blkbny/Solder-Station/SolderingStation-master 1.0 - Mathuis/SolderingStation-master/README.md

# SolderingStation
Schemetics and Code for a DIY weller soldering station
Find more infos at https://debugginglab.wordpress.com/2014/10/30/soldering-station/
