blkbny/Solder-Station/SolderingStation-master 1.0 - Mathuis/SolderingStation-master/eagle/BOM.html

Last update: |  | 02.07.15 01:56
EAGLE version: |  | EAGLE Version 6.1.0 Copyright (c) 1988-2012 CadSoft
Item No. | Part value | Description | ID(s) | Quantity
1 | 100n | C0603 | C1, C3, C4, C5, C6 | 5
2 | 10u 16V | C1206 | C2 | 1
3 | 10u 6V | C1206 | C7 | 1
4 | OPA336U | SO08 | IC1 | 1
5 | 78L05F | SOT89 | IC2 | 1
6 | POWER_JACKPTH | POWER_JACK_PTH | J1 | 1
7 | Display Header | 1X08_LOCK | JP1 | 1
8 |  | 1X02_LOCK_LONGPADS | JP2, JP3 | 2
9 | M01PTH | 1X01 | JP4 | 1
10 | 100R | R0603 | R1 | 1
11 | 56k | R0603 | R2 | 1
12 | 1k | R0603 | R3, R4, R5, R6, R7, R8, R9, R10, R15, R18 | 10
13 | 10k | R0603 | R11, R12, R14 | 3
14 | 1M | R0603 | R13, R16 | 2
15 | IRF7416 | SO8 | T1 | 1
16 | BSN138 | SOT23 | T2, T3 | 2
17 | ARDUINO_PRO_MINI | ARDUINO_PRO_MINI | U$1 | 1
18 | AUDIO_JACK_3,5MMCONRAD | AUDIO_JACK_3,5MM_CONRAD | U$2 | 1
19 | MW_LOGO | MW_11X5MM | U$3, U$5 | 2
20 | MW_LOGO_SOLDER | MW_11X5MM_SOLDER | U$4, U$9 | 2
21 | SOLDER_STATION19,5MM_BOT | SOLDER_STATION_19,5MM_BOT | U$6, U$7 | 2
22 | OSH_LOGOS | OSH_LOGO_S | U$8, U$10 | 2
Total |  |  |  | 44
