blkbny/Solder-Station/new version/SolderingStation-master v1.0 Mathius/list.xlsx

Ref | Value | Make | SN | Description | Optional | supplier | Cost of 1 | cost of 10 | cost of 50 | Amount |  | Total
C1, C3, C4, C5, C6 | 100n | Kemet | C1206C104K5RAC7867 | CAP CER 0.1UF 50V X7R 1206 |  | digikey | 0.1 | 0.073 | 0.0398 | 5 |  | 0.5
C2 | 10u 16V | Wurth Electronics Inc | 885012108017 | CAP CER 10UF 16V X5R 1206 |  | digikey | 0.43 | - | 0.3434 | 1 |  | 0.43
C7 | 10u 6V | Wurth Electronics Inc | 885012108002 | CAP CER 10UF 6.3V X5R 1206 |  | digikey | 0.43 | - | 0.3434 | 1 |  | 0.43
IC1 | OPA336U | Texas Instruments | OPA336UA | IC OPAMP GP 100KHZ RRO 8SOIC |  | digikey | 1.99 | 1.789 | - | 1 |  | 1.99
IC2 | 78L05F | STMicroelectronics | L78L05ABUTR | IC REG LDO 5V 0.1A SOT89-3 |  | digikey | 0.43 | 0.348 | - | 1 |  | 0.43
J1 | POWER_JACKPTH |  |  |  |  |  |  |  |  | 1 |  | 0
JP1 | Display Header 1X08_LOCK |  |  |  |  |  |  |  |  | 1 |  | 0
JP2, JP3 | Display Header 1X02_LOCK_LONGPADS |  |  |  |  |  |  |  |  | 2 |  | 0
JP4 | M01PTH 1X01 |  |  |  |  |  |  |  |  | 1 |  | 0
R1 | 100R | Bourns Inc | CR0603-JW-101ELF | RES SMD 100 OHM 5% 1/10W 0603 |  | digikey | 0.1 | 0.029 | 0.0158 | 1 |  | 0.1
R2 | 56k | Bourns Inc | CR0603-FX-5602ELF | RES SMD 56K OHM 1% 1/10W 0603 |  | digikey | 0.1 | 0.046 | 0.0254 | 1 |  | 0.1
R3, R4, R5, R6, R7, R8, R9, R10, R15, R18 | 1k | Bourns Inc | CR0603-JW-102ELF | RES SMD 1K OHM 5% 1/10W 0603 |  | digikey | 0.1 | 0.029 | 0.0158 | 10 |  | 0.29
R11, R12, R14 | 10k | Bourns Inc | CR0603-JW-103ELF | RES SMD 10K OHM 5% 1/10W 0603 |  | digikey | 0.1 | 0.029 | 0.0158 | 3 |  | 0.3
R13, R16 | 1M | Bourns Inc. | CR0603-JW-105ELF | RES SMD 1M OHM 5% 1/10W 0603 |  | digikey | 0.1 | 0.029 | 0.0158 | 2 |  | 0.2
T1 | IRF7416 | Infineon Technologies Americas Corp. | IRF7416PBF | MOSFET P-CH 30V 10A 8-SOIC |  | digikey | 1.33 | 0.821 | 0.6672 | 1 |  | 1.33
T2, T3 | bss138 | Fairchild Semiconductor | BSS138 | MOSFET N-CH 50V 220MA SOT-23 |  | digikey | 0.22 | 0.178 | - | 2 |  | 0.44
U1 | ARDUINO_PRO_MINI |  |  |  |  |  |  |  |  | 1 |  | 0
U2 | AUDIO_JACK_3,5MMCONRAD |  |  |  |  |  |  |  |  | 1 |  | 0
 |  |  |  |  |  |  |  |  |  |  | Total | 6.54
