blkbny/Solder-Station/SolderingStation-master 1.0 - Mathuis/SolderingStation-master/3D/tapon.SLDPRT

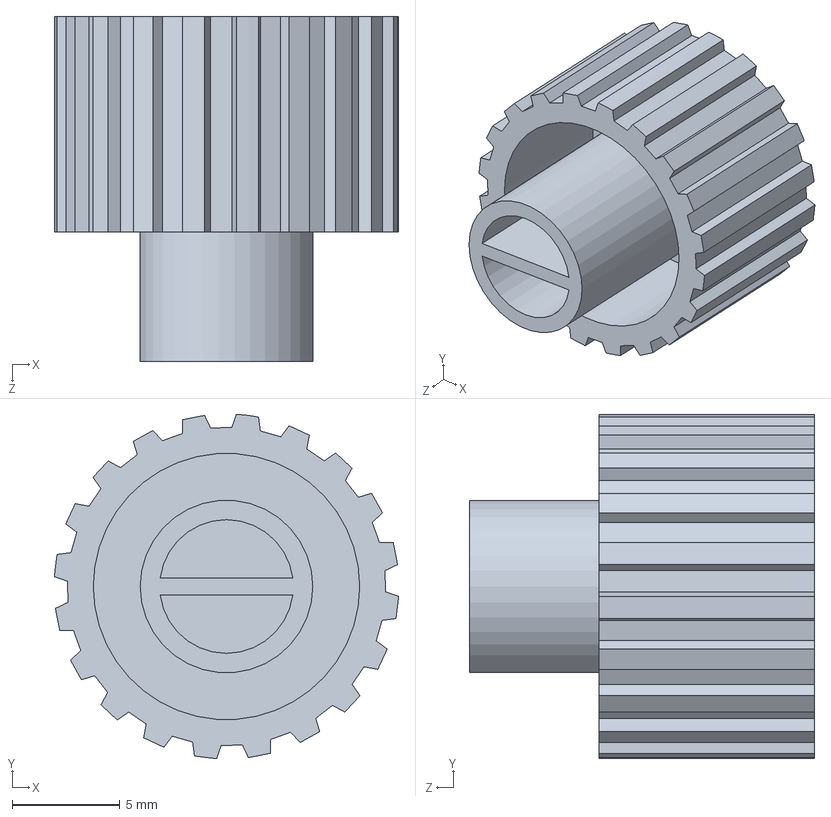
[picture p1: CAD file, 2015-12-15]
SolderingStation-master 1.0 - Mathuis/SolderingStation-master/3D/tapon.SLDPRT
16.0 x 16.0 x 16.0 mm
