blkbny/Solder-Station/SolderingStation-master 1.0 - Mathuis/SolderingStation-master/3D/lotstationtapa.SLDPRT

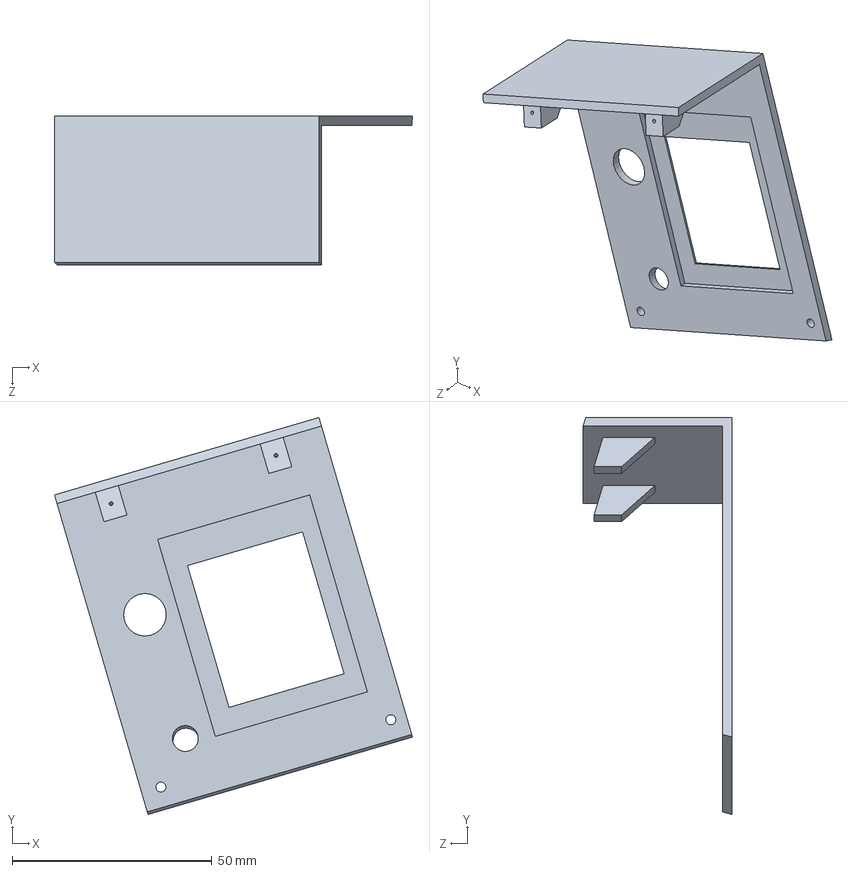
[picture p2: CAD file, 2015-12-15]
SolderingStation-master 1.0 - Mathuis/SolderingStation-master/3D/lotstationtapa.SLDPRT
89.6 x 99.4 x 37.3 mm
