blkbny/Solder-Station/SolderingStation-master 1.0 - Mathuis/SolderingStation-master/3D/lotstationv2.SLDPRT

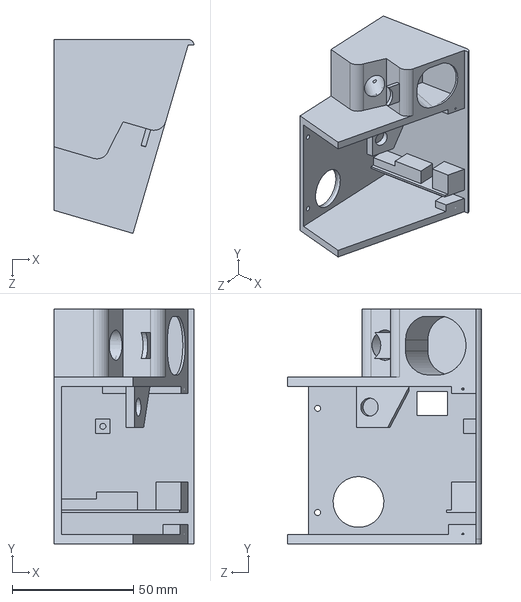
[picture p3: CAD file, 2015-12-15]
SolderingStation-master 1.0 - Mathuis/SolderingStation-master/3D/lotstationv2.SLDPRT
57.7 x 97.0 x 80.0 mm
