blkbny/Solder-Station/(list of files, cad)

Other CAD files:
universal solder iron/front/US_BootLoader.X/l.obj
universal solder iron/front/US_Firmware.X/l.obj
universal solder iron/sensor/US_sensor.X/dist/default/production/US_sensor.X.production.obj
universal solder iron/sensor/US_sensor.X/l.obj
SolderingStation-master 1.0 - Mathuis/SolderingStation-master/3D/lotstationtapa.STL
SolderingStation-master 1.0 - Mathuis/SolderingStation-master/3D/lotstationv2.STL
SolderingStation-master 1.0 - Mathuis/SolderingStation-master/3D/tapon.STL
