blkbny/Solder-Station/universal solder iron/gerber/unisolder52_full.txt

%FSTAX25Y25*%
%MOIN*%
%SFA1B1*%

%IPPOS*%
%ADD9500C,0.027990*%
%ADD9501C,0.031500*%
%ADD9502C,0.035430*%
%ADD9503C,0.039370*%
%ADD9504C,0.043310*%
%ADD9505C,0.047240*%
%ADD9506C,0.055120*%
%ADD9507C,0.066930*%
%ADD9508C,0.068900*%
%ADD9509C,0.090550*%
%ADD9510C,0.098430*%
%ADD9511C,0.125200*%
%ADD9512C,0.137800*%
%ADD9513C,0.145670*%
%LNunisolder52_full-1*%
%LPD*%
G54D9500*
X0136614Y0420866D03*
Y0427165D03*
Y0433465D03*
X0145276Y0430315D03*
Y0424016D03*
X0490256Y0275098D03*
X0490748Y0287894D03*
X0504528Y0288484D03*
X050689Y0299213D03*
X0495374Y0298524D03*
X0517913Y0302559D03*
X0525886Y0300886D03*
X0524311Y0290551D03*
X053435Y0289665D03*
X0535138Y0305315D03*
X054124Y0304429D03*
X0547244Y0305315D03*
X0558957Y0311516D03*
X0555118Y0289665D03*
X0544291Y0280413D03*
X0523228Y0275787D03*
X0576575Y028061D03*
X0576772Y0289862D03*
X0600394Y0291929D03*
X0607382Y0275787D03*
X0588583Y0308071D03*
X0453051Y029065D03*
X0452461Y0274902D03*
X0430315D03*
X04384Y0299095D03*
X0365256Y03D03*
X0364567Y0309449D03*
X0347091Y0312265D03*
X0343891Y0302165D03*
Y0296265D03*
X0345391Y0285465D03*
X0339491Y0286165D03*
X0332591Y0281465D03*
X0323591Y0291765D03*
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
