blkbny/Solder-Station/universal solder iron/resID.xlsx

Odd(red) resistor values for ID-Vout1- and for single resistor IDs (i.e. dual heater instruments) are reserved by the autor!
You can use them freely only on ID-Vout2.
ID(hex) | ID | R | Rmax | Rmin | ADCmin | ADCmax | ADCnom
1 | 1 | 100 | 101 | 99 | 89 | 93 | 87
2 | 2 | 110 | 111.1 | 108.9 | 97 | 102 | 95
3 | 3 | 120 | 121.2 | 118.8 | 105 | 110 | 103.5
4 | 4 | 130 | 131.3 | 128.7 | 113 | 118 | 111.5
5 | 5 | 150 | 151.5 | 148.5 | 128 | 135 | 123
6 | 6 | 180 | 181.8 | 178.2 | 150 | 157 | 142.5
7 | 7 | 200 | 202 | 198 | 164 | 172 | 160.5
8 | 8 | 220 | 222.2 | 217.8 | 177 | 186 | 174.5
9 | 9 | 240 | 242.4 | 237.6 | 190 | 199 | 188
A | 10 | 270 | 272.7 | 267.3 | 208 | 219 | 203.5
B | 11 | 300 | 303 | 297 | 226 | 238 | 222.5
C | 12 | 330 | 333.3 | 326.7 | 243 | 255 | 240.5
D | 13 | 390 | 393.9 | 386.1 | 273 | 289 | 264
E | 14 | 430 | 434.3 | 425.7 | 293 | 309 | 291
F | 15 | 470 | 474.7 | 465.3 | 310 | 329 | 309.5
10 | 16 | 560 | 565.6 | 554.4 | 347 | 370 | 338
11 | 17 | 680 | 686.8 | 673.2 | 389 | 417 | 379.5
12 | 18 | 820 | 828.2 | 811.8 | 432 | 463 | 424.5
13 | 19 | 1000 | 1010 | 990 | 476 | 514 | 469.5
14 | 20 | 1200 | 1212 | 1188 | 517 | 561 | 515.5
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
