blkbny/Solder-Station/universal solder iron/UniSolder52_back.pdf

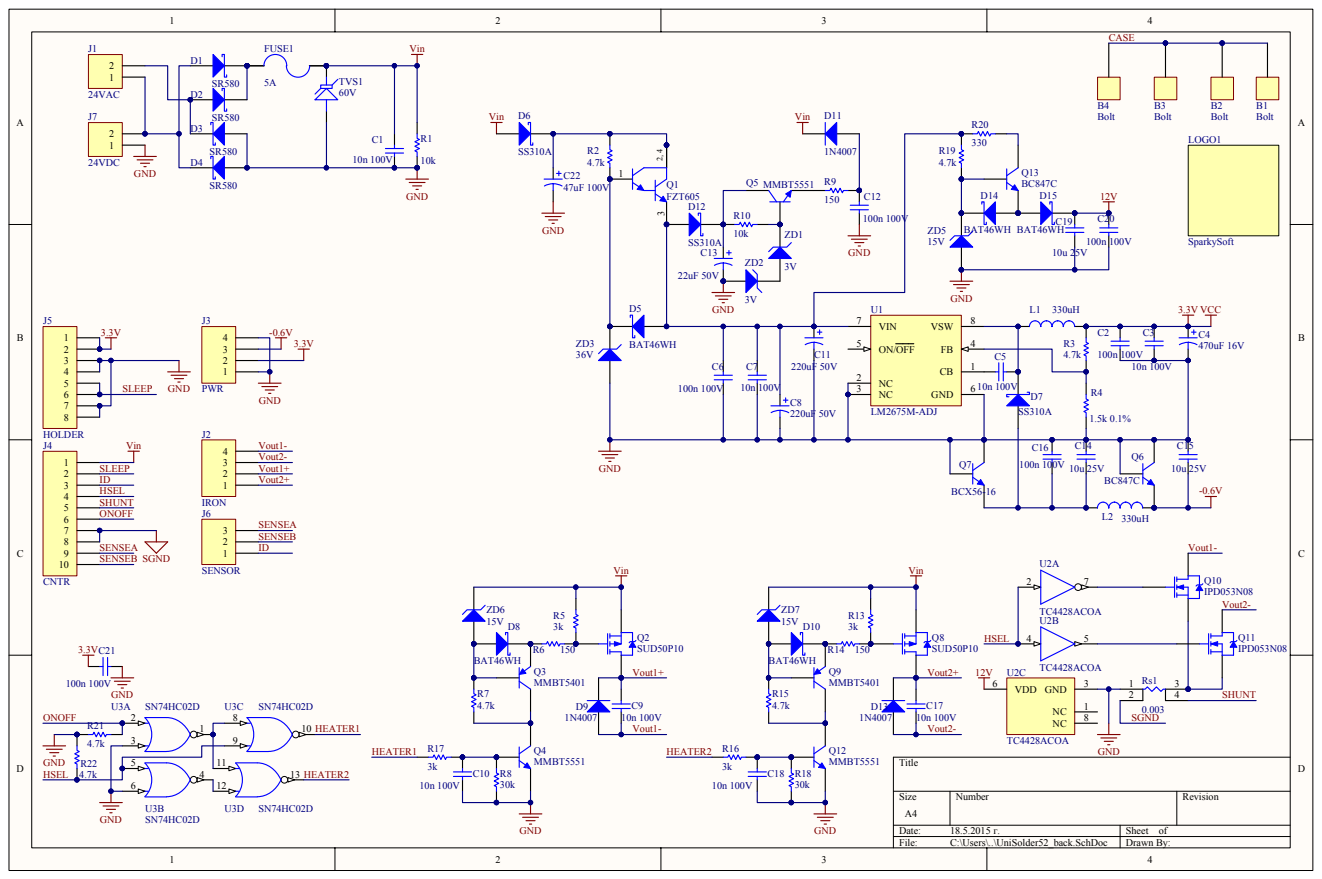
[picture p4: page 1]

Size A4 | Number | Revision

Date: 18.5.2015 г. | Sheet of
File: C:\Users\..\UniSolder52_back.SchDoc | Drawn By:
