blkbny/Solder-Station/universal solder iron/UniSolder52_OLED.pdf

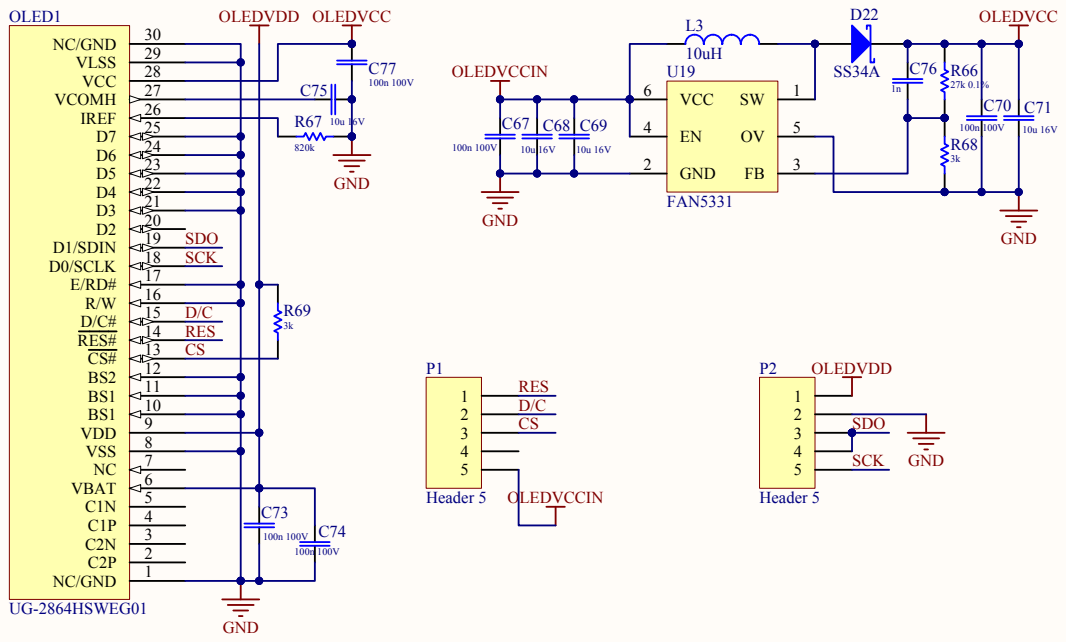
[picture p5: page 1]

Size A4 | Number | Revision

Date: 14.1.2015 г. | Sheet of
File: C:\Users\..\UniSolder52_OLED.SchDoc | Drawn By:
