blkbny/Solder-Station/universal solder iron/UniSolder_sensor.pdf

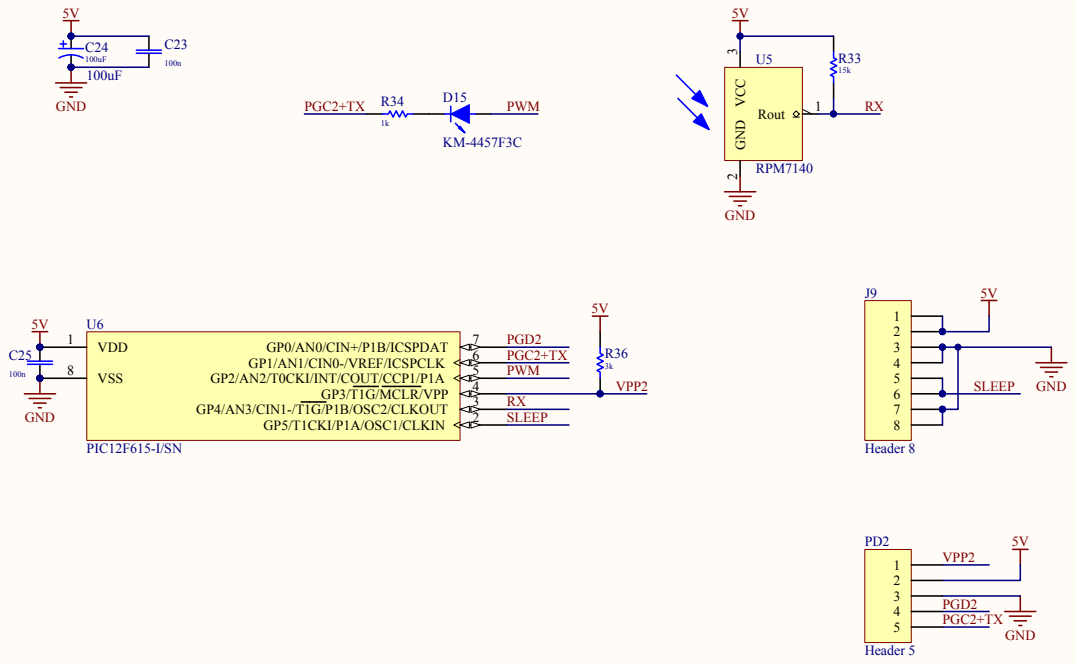
[picture p6: page 1]

Size A4 | Number | Revision

Date: 14.11.2014 г. | Sheet of
File: C:\Users\..\UniSolder_sensor.SchDoc | Drawn By:
