blkbny/Solder-Station/new version/eagle/solderiron2.0/SolderIron2.0.brd

## EAGLE design new version/eagle/solderiron2.0/SolderIron2.0.brd (2016-01-11)

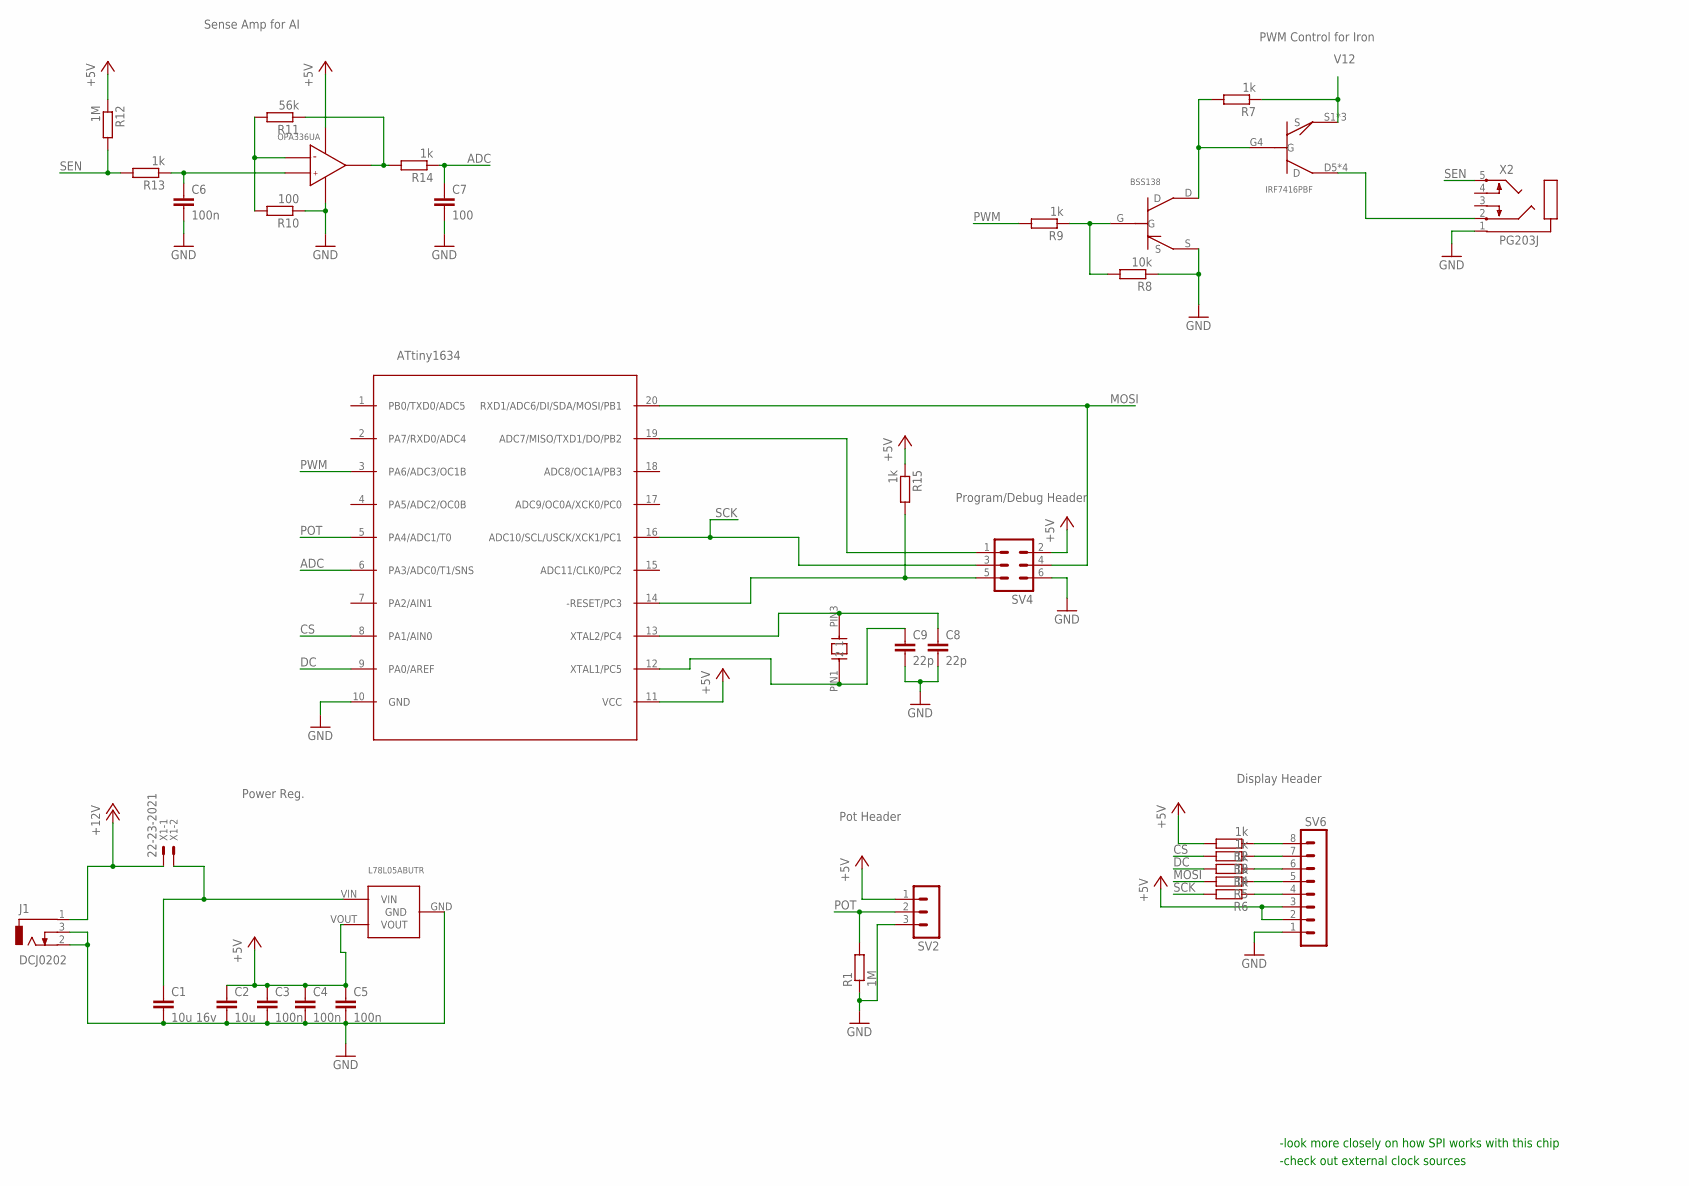
[picture p7: schematic SolderIron2.0.sch]

Parts:
C1: 10u 16v; C1206
C2: 10u; C1206
C3, C4, C5, C6: 100n; C1206
C7: 100; C1206
C8, C9: 22p; C1206
J1: DCJ0202; POWERJACK2.1MM
R1, R12: 1M; R0603
R2, R3, R4, R5, R6, R7, R9, R13, R14, R15: 1k; R0603
R8: 10k; R0603
R10: 100; R0603
R11: 56k; R0603
SV2: MA03-1
SV4: MA03-2
SV6: MA08-1
U$1: IRF7416PBF; 8-SOIC
U$2: L78L05ABUTR; SOT89-3
U$3: BSS138; SOT-23
U$4: OPA336UA; 8-SOIC
U$5: ATTINY1634; SOIC20
U$6: CX3225GB12000H0KPSC1; 4-SIZ
X1: 22-23-2021
X2: PG203J

Connections:
+5V: C2.1, C3.1, C4.1, C5.1, R2.2, R12.1, R15.1, SV2.1, SV4.2, SV6.2, SV6.3, U$2.VOUT, U$4.D7 (V+), U$5.11 (VCC)
+12V: J1.1, X1.1
ADC: C7.1, R14.1, U$5.6 (PA3/ADC0/T1/SNS)
CS: R3.2, U$5.8 (PA1/AIN0)
DC: R4.2, U$5.9 (PA0/AREF)
GND: C1.2, C2.2, C3.2, C4.2, C5.2, C6.2, C7.2, C8.2, C9.2, J1.2 (3), J1.3 (2), R1.1, R8.1, R10.1, SV2.3, SV4.6, SV6.1, U$2.GND, U$3.S, U$4.G4 (V-), U$5.10 (GND), X2.1
MOSI: R5.2, SV4.4, U$5.20 (RXD1/ADC6/DI/SDA/MOSI/PB1)
unnamed: C8.1, U$5.13 (XTAL2/PC4), U$6.PIN3 (2)
unnamed: R2.1, SV6.8
unnamed: R3.1, SV6.7
unnamed: R4.1, SV6.6
unnamed: R5.1, SV6.5
unnamed: R6.1, SV6.4
unnamed: U$1.D5 (D), U$1.D6 (D), U$1.D7 (D), U$1.D8 (D), X2.2
unnamed: R7.2, U$1.G4 (G), U$3.D
unnamed: R8.2, R9.1, U$3.G
unnamed: R10.2, R11.2, U$4.S2 (IN-)
unnamed: R11.1, R14.2, U$4.D6 (OUTPUT)
unnamed: C6.1, R13.1, U$4.S3 (IN+)
unnamed: C9.1, U$5.12 (XTAL1/PC5), U$6.PIN1 (1)
unnamed: SV4.1, U$5.19 (ADC7/MISO/TXD1/DO/PB2)
unnamed: R15.2, SV4.5, U$5.14 (-RESET/PC3)
POT: R1.2, SV2.2, U$5.5 (PA4/ADC1/T0)
PWM: R9.2, U$5.3 (PA6/ADC3/OC1B)
SCK: R6.2, SV4.3, U$5.16 (ADC10/SCL/USCK/XCK1/PC1)
SEN: R12.2, R13.2, X2.5
V12: C1.1, R7.1, U$1.S1 (S), U$1.S2 (S), U$1.S3 (S), U$2.VIN, X1.2

Notes on the sheet:
Power Reg.
Pot Header
Display Header
PWM Control for Iron
Sense Amp for AI
Program/Debug Header
-look more closely on how SPI works with this chip
-check out external clock sources

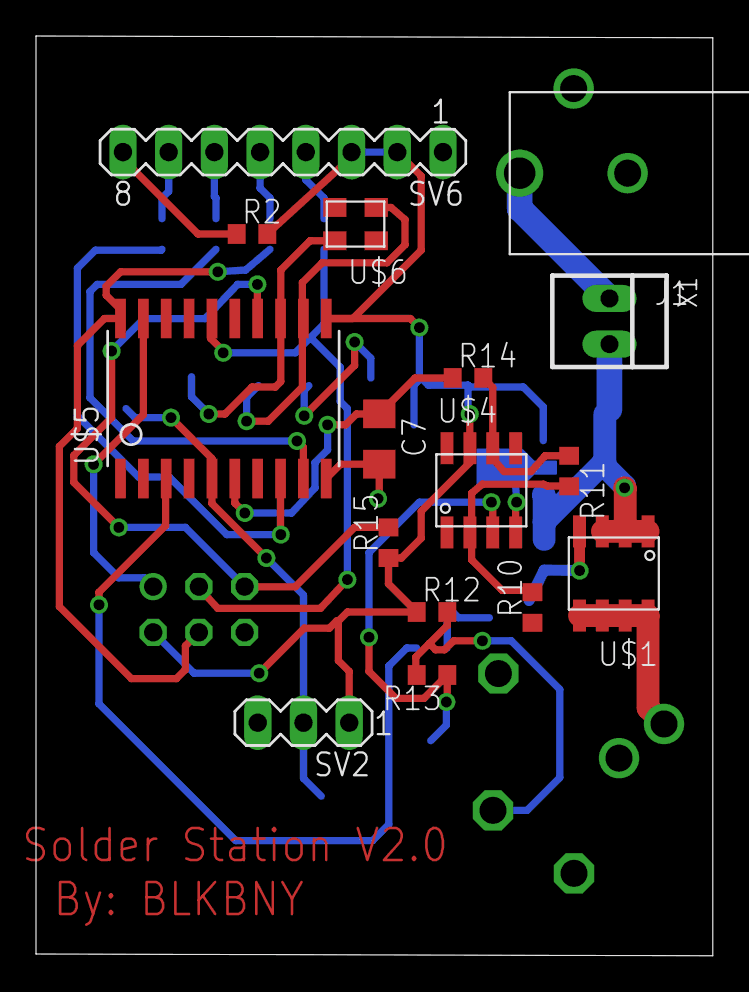
[picture p8: board SolderIron2.0.brd from above]

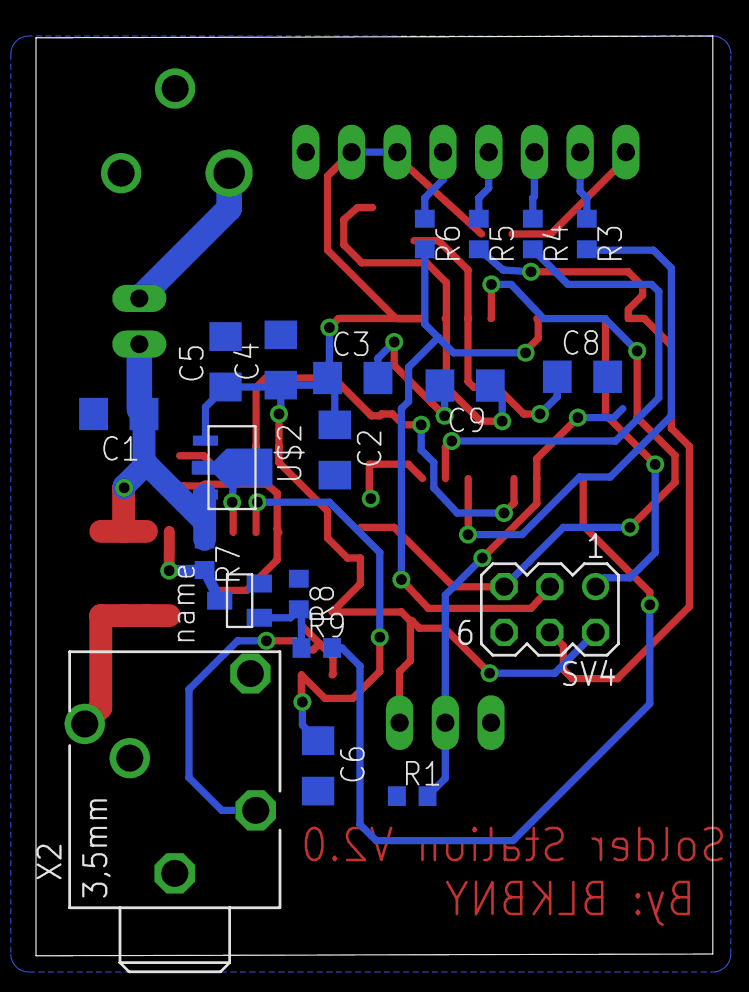
[picture p9: board SolderIron2.0.brd from below]

Board: 2 copper layers, 37.6 x 51.1 mm, 36 parts (20 on the bottom side), 27 nets.
