blkbny/Solder-Station/universal solder iron/front/US_Firmware.X/PIC32MX534F064H.c

#define _PIC32MX534F064H_C

#include <xc.h>
// DEVCFG3
// USERID = No Setting
#pragma config FSRSSEL = PRIORITY_7     // SRS Select (SRS Priority 7)
#pragma config FCANIO = OFF             // CAN I/O Pin Select (Alternate CAN I/O)
#pragma config FUSBIDIO = OFF           // USB USID Selection (Controlled by Port Function)
#pragma config FVBUSONIO = OFF          // USB VBUS OFF Selection (Not Controlled by USB Module)

// DEVCFG2
#pragma config FPLLIDIV = DIV_2         // PLL Input Divider (2x Divider)
#pragma config FPLLMUL = MUL_20         // PLL Multiplier (20x Multiplier)
#pragma config UPLLIDIV = DIV_2         // USB PLL Input Divider (2x Divider)
#pragma config UPLLEN = ON              // USB PLL Enable (Enabled)
#pragma config FPLLODIV = DIV_1         // System PLL Output Clock Divider (PLL Divide by 1)

// DEVCFG1
#pragma config FNOSC = PRIPLL           // Oscillator Selection Bits (Primary Osc w/PLL (XT+,HS+,EC+PLL))
#pragma config FSOSCEN = OFF            // Secondary Oscillator Enable (Disabled)
#pragma config IESO = OFF               // Internal/External Switch Over (Disabled)
#pragma config POSCMOD = XT             // Primary Oscillator Configuration (XT osc mode)
#pragma config OSCIOFNC = OFF           // CLKO Output Signal Active on the OSCO Pin (Disabled)
#pragma config FPBDIV = DIV_2           // Peripheral Clock Divisor (Pb_Clk is Sys_Clk/1)
#pragma config FCKSM = CSDCMD           // Clock Switching and Monitor Selection (Clock Switch Disable, FSCM Disabled)
#pragma config WDTPS = PS1048576        // Watchdog Timer Postscaler (1:1048576)
#pragma config FWDTEN = OFF             // Watchdog Timer Enable (WDT Disabled (SWDTEN Bit Controls))

// DEVCFG0
#pragma config DEBUG = OFF              // Background Debugger Enable (Debugger is disabled)
#pragma config ICESEL = ICS_PGx2        // ICE/ICD Comm Channel Select (ICE EMUC2/EMUD2 pins shared with PGC2/PGD2)
#pragma config PWP = OFF                // Program Flash Write Protect (Disable)
#pragma config BWP = OFF                // Boot Flash Write Protect bit (Protection Disabled)
#pragma config CP = OFF                 // Code Protect (Protection Disabled)

#include <GenericTypeDefs.h>
#include "PIC32MX534F064H.h"
#include <peripheral/system.h>
#include <peripheral/cmp.h>
#include <peripheral/timer.h>
#include <peripheral/ports.h>
#include <peripheral/adc10.h>
#include <peripheral/dma.h>
#include <peripheral/cvref.h>
#include <peripheral/cmp.h>
#include <peripheral/outcompare.h>
#include <peripheral/int.h>

#include "main.h"
#include "isr.h"

void mcuInit1(){
    INTDisableInterrupts();
    OpenCoreTimer(0xFFFFFFFF);
    SYSTEMConfigWaitStates(80000000);

    LATB=0b1000000000000000;
    LATC=0b0110000000000000;
    LATD=0b100001010000;
    LATE=0;
    LATF=0;
    LATG=0;
    TRISB=0b1100000000111111;
    TRISC=0b1001000000000000;
    TRISD=0;
    TRISE=0;
    TRISF=0;
    TRISG=0b1000111111;
    ODCB=0;
    ODCC=0;
    ODCD=0;
    ODCE=0;
    ODCF=0;
    ODCG=0;

    TRISBbits.TRISB7=0;

    HCH=0;
    ID_3S=0;
    ID_OUT=0;
    HEATER=0;
    CBANDA=1;
    CBANDB=1;
    CHSEL1=0;
    CHSEL2=1;
    CHPOL=0;

    SPEAKER=1;

    mcuADCStop();
}

void mcuInit2(){

    OpenTimer3(T3_ON | T3_IDLE_STOP | T3_GATE_OFF | T3_PS_1_256 | T3_SOURCE_INT, 40);
    OpenOC1(OC_ON | OC_IDLE_STOP | OC_TIMER_MODE16 | OC_TIMER3_SRC | OC_PWM_FAULT_PIN_DISABLE, 0x20, 0);

    DmaEnable(1);

    I2CEnable(I2C4, FALSE);
    mcuI2CReset();
    I2CSetFrequency(I2C4, PER_FREQ, 400000);
    I2CEnable(I2C4,TRUE);

    CVREFOpen(CVREF_ENABLE | CVREF_OUTPUT_DISABLE | CVREF_RANGE_HIGH | CVREF_SOURCE_VREF);
    COMPREF = 2; //(3*(0.25+2/32))*6 = 5.625V on Vin
    CMP2Open(CMP_STOP_IN_IDLE | CMP_ENABLE | CMP_OUTPUT_DISABLE | CMP_OUTPUT_INVERT | CMP_EVENT_HIGH_TO_LOW | CMP_POS_INPUT_CVREF | CMP2_NEG_INPUT_C2IN_NEG);
}

unsigned int mcuSqrt(register unsigned int n){
    register unsigned int r, x;
    r=0;
    for(x = 0x8000L; x; x >>= 1){
        r += x;
        if((UINT32)(r * r) > n)r -= x;
    }
    return r;
}

void DelayTicks(UINT32 a){
    UINT32 StartTime;
    StartTime=ReadCoreTimer();
    while((UINT32)(ReadCoreTimer()-StartTime)<a){};
}

void mcuJumpToBootLoader(){
    NVMDATA=0x6193471A;
    SoftReset();
}

void mcuSPIWait(){
    while(mcuSPIIsBusy());
}

void mcuI2CReset()
{
    SDALAT=0;
    SCLLAT=0;
    SCL=1;
    SDAOUT=1;
    _delay_us(100);
    while(SDA==0){
        SCL=0;
        _delay_us(100);
        SCL=1;
        _delay_us(100);
    }
    SDAOUT=0;
    _delay_us(100);
    SDAOUT=1;
    _delay_us(100);
}

void mcuDCTimerReset(){
    WriteTimer1(0);
    mT1ClearIntFlag();
}

void mcuInitISRTimer(){
    OpenTimer2(T2_OFF | T2_IDLE_STOP | T2_GATE_OFF | T2_PS_1_256 | T2_32BIT_MODE_OFF | T2_SOURCE_INT,0xFFFF);
    ConfigIntTimer2(T2_INT_ON | T2_INT_PRIOR_7 | T2_INT_SUB_PRIOR_3);
}

void mcuStartISRTimer(unsigned int per)
{
    WriteTimer2(0);
    WritePeriod2(per);
    T2CONbits.ON = 1;
}

void mcuStopISRTimer(){
    WriteTimer2(0);
    T2CONbits.ON = 0;
    mT2ClearIntFlag();
}

int ADCAuto = 0;

void mcuADCStop(){
    int i;
    if(ADCAuto && !VIBuffCnt) VIBuffCnt = DmaChnGetDstPnt(DMA_CHANNEL0);
    DmaChnAbortTxfer(DMA_CHANNEL0);
    DmaChnAbortTxfer(DMA_CHANNEL1);
    DmaChnDisable(DMA_CHANNEL0);
    DmaChnDisable(DMA_CHANNEL1);
    CloseADC10();
    i=ADC1BUF0;
    i=ADC1BUF1;
    i=ADC1BUF2;
    i=ADC1BUF3;
    i=ADC1BUF4;
    i=ADC1BUF5;
    i=ADC1BUF6;
    i=ADC1BUF7;
    i=ADC1BUF8;
    i=ADC1BUF9;
    i=ADC1BUFA;
    i=ADC1BUFB;
    i=ADC1BUFC;
    i=ADC1BUFD;
    i=ADC1BUFE;
    i=ADC1BUFF;
    mAD1ClearIntFlag();
    mAD1IntEnable(0);
    ADCAuto=0;
}

void mcuADCStartManual(){
    mcuADCStop();
    OpenADC10(\
            ADC_MODULE_ON | ADC_IDLE_STOP | ADC_FORMAT_INTG16 | ADC_CLK_AUTO | ADC_AUTO_SAMPLING_OFF | ADC_SAMP_OFF , \
            ADC_VREF_EXT_EXT | ADC_OFFSET_CAL_DISABLE | ADC_SCAN_OFF | ADC_SAMPLES_PER_INT_1 | ADC_BUF_16 | ADC_ALT_INPUT_OFF, \
            ADC_SAMPLE_TIME_13 | ADC_CONV_CLK_PB | ADC_CONV_CLK_5Tcy, \
            ENABLE_AN0_ANA | ENABLE_AN1_ANA | ENABLE_AN2_ANA | ENABLE_AN3_ANA | ENABLE_AN4_ANA | ENABLE_AN5_ANA | ENABLE_AN14_ANA, \
            SKIP_SCAN_ALL);
    AD1CON1bits.CLRASAM = 0;
    mAD1IntEnable(1);
    ADCAuto = 0;
}

void mcuADCStartAuto(){
    mcuADCStop();

    DmaChnDisable(DMA_CHANNEL0);
    DmaChnOpen(DMA_CHANNEL0,DMA_CHN_PRI0,DMA_OPEN_DEFAULT);
    DmaChnSetEventControl(DMA_CHANNEL0, DMA_EV_START_IRQ_EN | DMA_EV_START_IRQ(_ADC_IRQ));
    DmaChnSetTxfer(DMA_CHANNEL0,(void*)&ADC1BUF0,(void*)VBuff,2,sizeof(VBuff),2);
    DmaChnWriteEvEnableFlags(DMA_CHANNEL0,0);
    DmaChnEnable(DMA_CHANNEL0);

    DmaChnDisable(DMA_CHANNEL1);
    DmaChnOpen(DMA_CHANNEL1,DMA_CHN_PRI0,DMA_OPEN_DEFAULT);
    DmaChnSetEventControl(DMA_CHANNEL1, DMA_EV_START_IRQ_EN | DMA_EV_START_IRQ(_ADC_IRQ));
    DmaChnSetTxfer(DMA_CHANNEL1,(void*)&ADC1BUF1,(void*)IBuff,2,sizeof(IBuff),2);
    DmaChnWriteEvEnableFlags(DMA_CHANNEL1,0);
    DmaChnEnable(DMA_CHANNEL1);

    SetChanADC10(ADCH_VIN | (ADCH_VSHUNT<<8));
    OpenADC10(\
            ADC_MODULE_ON | ADC_IDLE_STOP | ADC_FORMAT_INTG16 | ADC_CLK_AUTO | ADC_AUTO_SAMPLING_ON | ADC_SAMP_ON , \
            ADC_VREF_EXT_EXT | ADC_OFFSET_CAL_DISABLE | ADC_SCAN_OFF | ADC_SAMPLES_PER_INT_2 | ADC_BUF_16 | ADC_ALT_INPUT_ON, \
            ADC_SAMPLE_TIME_31 | ADC_CONV_CLK_PB | ADC_CONV_CLK_63Tcy2, \
            ENABLE_AN0_ANA | ENABLE_AN1_ANA | ENABLE_AN2_ANA | ENABLE_AN3_ANA | ENABLE_AN4_ANA | ENABLE_AN5_ANA | ENABLE_AN14_ANA, \
            SKIP_SCAN_ALL);
    AD1CON1bits.CLRASAM = 0;
    ADCAuto = 1;
}

void mcuADCRead(int ADCCH, int num){
    SetChanADC10(ADCCH);
    AD1CON2bits.SMPI = num-1;
    AD1CON1bits.ASAM = 1;
    AD1CON1bits.CLRASAM = 1;
    AcquireADC10();
}

int mcuADCReadWait(int ADCCH, int num){
    int ADCInt,i;
    ADCInt = mAD1GetIntEnable();
    mAD1IntEnable(0);
    mAD1ClearIntFlag();
    mcuADCRead(ADCCH, num);
    while(!mAD1GetIntFlag());
    i=0;
    while(num--) i += ReadADC10(num);
    mAD1ClearIntFlag();
    mAD1IntEnable(ADCInt);
    return i;
}

static UINT32 H2LTime = 0;
void __ISR(_COMPARATOR_2_VECTOR, IPL7SRS) ComparatorISR(void)
{
    static int oh;
    static int oas;
    UINT32 ccon = CM2CON;
    mcuCompDisable();
    if(ccon & CMP_EVENT_HIGH_TO_LOW){
        mcuDCTimerReset();
        oh = HEATER;
        oas = (ADCStep & 1);
        //if(oh && oas)LATBbits.LATB7 = 1;
        H2LTime = ReadCoreTimer();
        ISRHigh(CompH2L);
    }
    else{
        CompLowTime = 0;
        if(H2LTime){
            CompLowTime = (ReadCoreTimer() - H2LTime) / 80;
            H2LTime = 0;
            //if(oh && oas)LATBbits.LATB7 = 0;
        }
        ISRHigh(CompL2H);
    }
}

void __ISR(_TIMER_1_VECTOR, IPL7SRS) Timer1ISR(void)
{
    mT1ClearIntFlag();
    H2LTime = 0;
    CompLowTime = 0;
    ISRHigh(DCTimer);
}

void __ISR(_TIMER_2_VECTOR, IPL7SRS) Timer2ISR(void)
{
    mT2ClearIntFlag();
    T2CONbits.ON = 0;
    ISRHigh(0);
}

void __ISR(_ADC_VECTOR,IPL7SRS) ADCISR(void)
{
    int n, i=0;
    for(n = AD1CON2bits.SMPI + 1; n--;) i += ReadADC10(n);
    mcuADCRES = i;
    mAD1ClearIntFlag();
    ISRHigh(0);
}

void __ISR(_I2C_4_VECTOR,IPL6SOFT) I2CISR(void)
{
    INTClearFlag(INT_I2C4B);
    INTClearFlag(INT_I2C4M);
    INTClearFlag(INT_I2C4S);
    INTClearFlag(INT_I2C4);
    I2CISRTasks();
}

void __ISR(_OUTPUT_COMPARE_2_VECTOR,IPL5SOFT) PIDISR(void){
    INTClearFlag(INT_OC2);
}

#undef _PIC32MX534F064H_C
