blkbny/Solder-Station/universal solder iron/front/US_Firmware.X/ExtFloat.h

/* 
 * File:   ExtFloat.h
 * Author: Sparky
 *
 * Created on ??????, 2015, ??? 17, 19:35
 */

#ifndef EXTFLOAT_H
#define	EXTFLOAT_H

#ifdef	__cplusplus
extern "C" {
#endif

typedef union{
    struct __PACKED
    {
        unsigned int m:23;
        unsigned int e:8;
        unsigned int s:1;
    };
    float f;
}SFLOAT;

typedef struct {
    UINT32 m;
    INT32 e;
}ExtFloat;

#define float2ExtFloat(ef, f) \
{ \
    ef.m = ( ((UINT32)((SFLOAT)f).m) | 0x800000UL) << 8; \
    ef.e = ((SFLOAT)f).e; \
}

#define ExtFloatDivByUInt(ef, ui) \
{ \
    if(ef.m /= ui){ \
        while (ef.m < 0x80000000UL){ \
            ef.m <<= 1; \
            ef.e--; \
        } \
    } \
    else { \
        ef.e = 0; \
    } \
}

#define ExtFloatMul(ef1, ef2) \
{ \
    if(ef1.m = ((UINT64)ef1.m * (UINT64)ef2.m) >> 32){ \
        ef1.e += ef2.e - 126; \
        while(ef1.m < 0x80000000UL){ \
            ef1.m <<= 1; \
            ef1.e--; \
        } \
    } \
    else { \
        ef1.e = 0; \
    } \
}

#define ExtFloatAdd(ef1, ef2) \
{\
    if(ef1.e >= ef2.e){ \
        if((ef1.e - ef2.e) < 31){ \
            if(ef1.m = (ef1.m >> 1) + (ef2.m >> (ef1.e - ef2.e + 1))){ \
                if(ef1.m >= 0x80000000UL){ \
                    ef1.e++; \
                } \
                else{ \
                    ef1.m <<= 1; \
                } \
            }\
            else{ \
                ef1.e = 0; \
            } \
        } \
    } \
    else { \
        if((ef2.e - ef1.e) < 31){ \
            if(ef1.m = (ef2.m >> 1) + (ef1.m >> (ef2.e - ef1.e + 1))){ \
                ef1.e = ef2.e; \
                if(ef1.m >= 0x80000000UL){ \
                    ef1.e++; \
                } \
                else{ \
                    ef1.m <<= 1; \
                } \
            }\
            else{ \
                ef1.e = 0; \
            } \
        } \
        else{ \
            ef1 = ef2; \
        } \
    } \
}
#ifdef	__cplusplus
}
#endif

#endif	/* EXTFLOAT_H */
