blkbny/Solder-Station/universal solder iron/front/US_Firmware.X/mcu.h

/* 
 * File:   mcu.h
 * Author: Sparky
 *
 * Created on ?????, 2013, ??? 31, 0:00
 */

#ifndef MCU_H
#define	MCU_H

#ifdef	__cplusplus
extern "C" {
#endif
    
#include <xc.h>

#ifdef __32MX534F064H__
#include "PIC32MX534F064H.h"
#endif




#ifdef	__cplusplus
}
#endif

#endif	/* MCU_H */
