blkbny/Solder-Station/universal solder iron/front/US_Firmware.X/menu.h

/* 
 * File:   menu.h
 * Author: Sparky
 *
 * Created on ???????, 2013, ??? 2, 23:27
 */

#ifndef MENU_H
#define	MENU_H

#ifdef	__cplusplus
extern "C" {
#endif

extern void MenuInit();
extern void MenuTasks();

#ifdef	__cplusplus
}
#endif

#endif	/* MENU_H */
