blkbny/Solder-Station/(commit log)

2015-12-15 adding open source base project for modification
    [list.xlsx, lotstationtapa.SLDPRT, lotstationtapa.STL, lotstationv2.SLDPRT, lotstationv2.STL, pin assign - ATtiny1634.xlsx, solderstation_v1_6.brd, solderstation_v1_6.sch]
2015-12-18 added another solder project for reference
    [US_sensor.X.production.obj, UniSolder52_BOM.xls, l.obj, lotstationtapa.SLDPRT, lotstationtapa.STL, lotstationv2.SLDPRT, lotstationv2.STL, resID.xlsx]
2015-12-21 added powersupply circuit
    [SolderIron2.0.sch, sloderiron2.0.brd]
2015-12-22 created eagle schematics
    [SolderIron2.0.sch, pin assign - ATtiny1634.xlsx, sloderiron2.0.brd]
2015-12-23 finished v2 schematic
    [SolderIron2.0.sch]
2015-12-23 first board setup
    [SolderIron2.0.brd, SolderIron2.0.sch]
2016-01-04 created new PCB layout
2016-01-05 finished PCB part layout
    [SolderIron2.0.sch]
2016-01-11 routed new board
    [SolderIron2.0.brd, SolderIron2.0.sch]
2016-01-11 added title to PCB
    [SolderIron2.0.brd]
2016-01-11 added Gerber files for V2.0
